AstroNolan/LU2EE20A_RefluxDansLesSoupapes/README.md

Projet universitaire d'électronique, permettant de déterminer le sens du flux d'air dans un tube (en se basant principalement sur le traitement analogique puis numérique de capteurs de température)
