AstroNolan/LU2EE20A_RefluxDansLesSoupapes/Mecanique - La Boite/Base.STEP

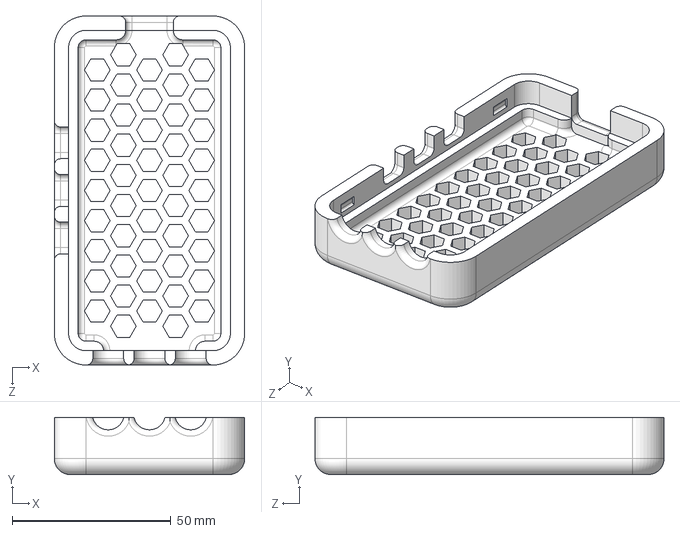
[picture p7: CAD file, 2025-03-15]
Mecanique - La Boite/Base.STEP
60.0 x 18.0 x 110.0 mm
