AstroNolan/LU2EE20A_RefluxDansLesSoupapes/Mecanique - La Boite/PCB.SLDPRT

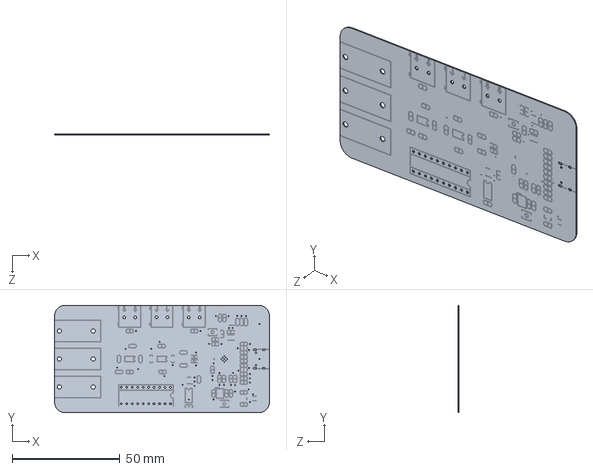
[picture p8: CAD file, 2025-03-15]
Mecanique - La Boite/PCB.SLDPRT
100.0 x 50.0 x 0.431 mm
