AstroNolan/LU2EE20A_RefluxDansLesSoupapes/Mecanique - La Boite/Chapo.STEP

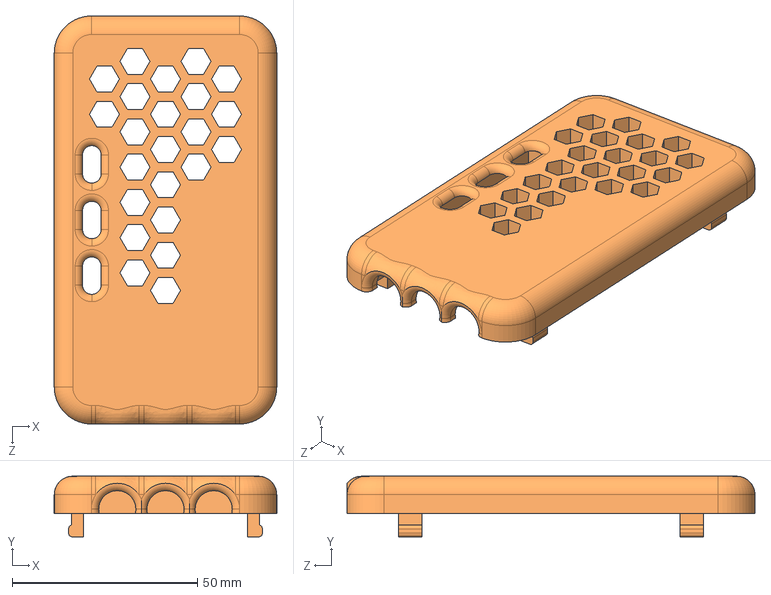
[picture p9: CAD file, 2025-03-15]
Mecanique - La Boite/Chapo.STEP
60.0 x 16.4 x 110.0 mm
