AstroNolan/LU2EE20A_RefluxDansLesSoupapes/Mecanique - La Boite/LaBoite.SLDASM

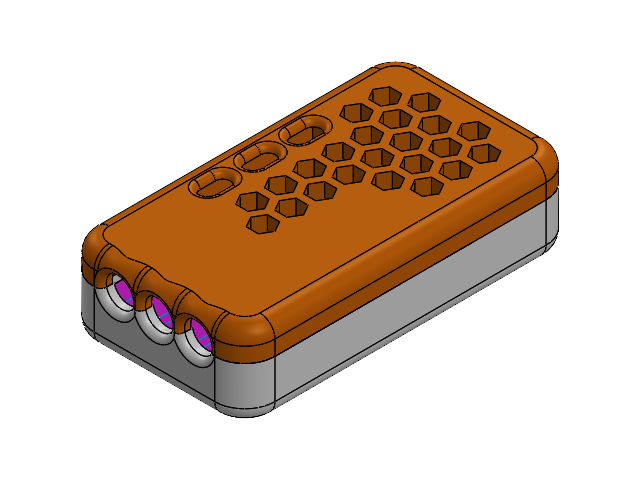
[picture p10: CAD file, 2025-03-15]
Mecanique - La Boite/LaBoite.SLDASM
Base
PCB
Chapo
