AstroNolan/LU2EE20A_RefluxDansLesSoupapes/(list of files, cad)

Other CAD files:
Mecanique - La Boite/Base.SLDPRT
Mecanique - La Boite/Chapo.SLDPRT
