AstroNolan/LU2EE20A_RefluxDansLesSoupapes/Electronique - Les Soupapes de l'Extrême/Les Soupapes de l'Extrême.pdf

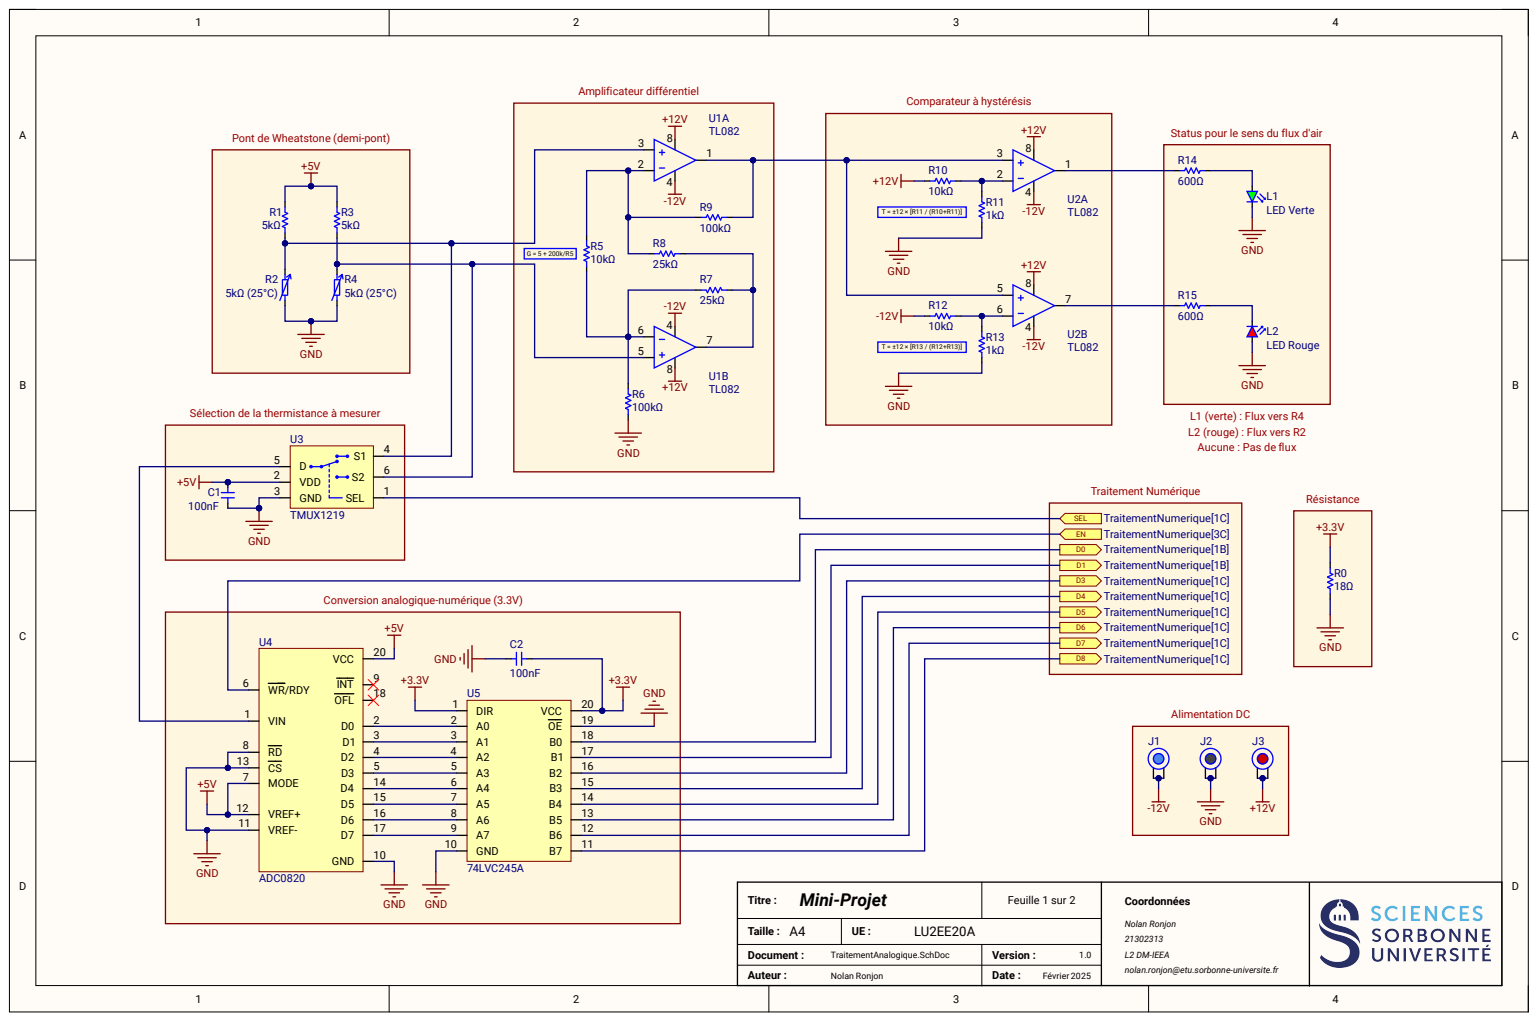
[picture p11: page 1]

Pont de Wheatstone (demi-pont)

Status pour le sens du f

élection de la thermistance

Conversion analogique-num érique (3.3V)

Mini-Projet | F euille 1 sur 2 | Coordonn ées Nolan Ronjon 21302313 L2 DM-IEEA nolan .ronjon@etu .sorbon ne-u niversite. fr

Document : T raitementAnalogique.SchDo c | Version : 1 . 0

Auteur : Nolan Ronjon | Date : F évrier 2 0 2 5

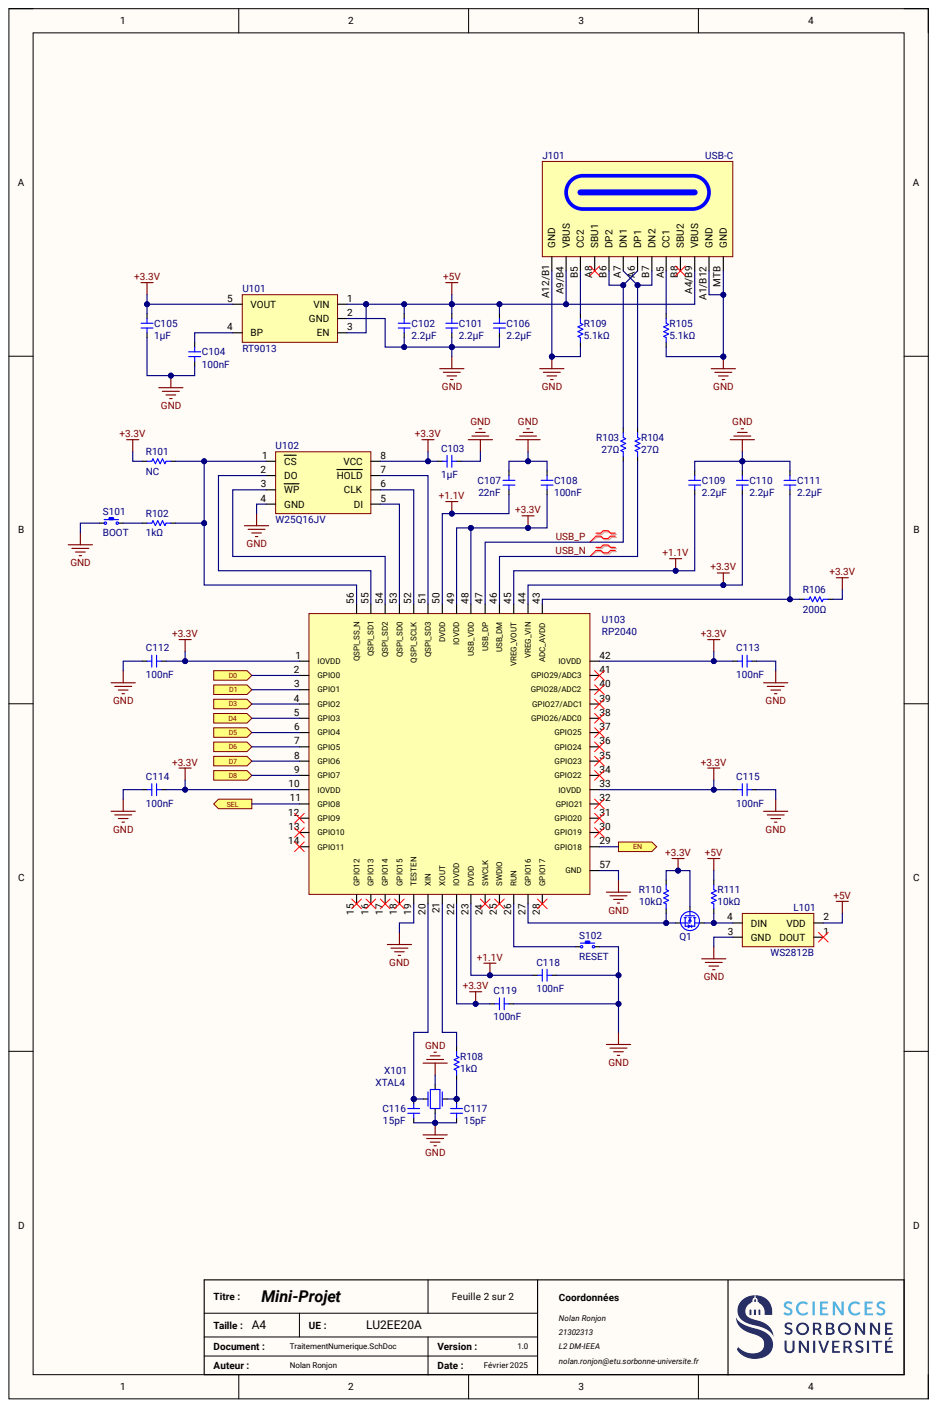
[picture p12: page 2]

GND MTB GND A1/B12 VBUS A4/B9

Mini-Projet Titre : | Feuille 2 sur 2 | Coordonnées Nolan Ronjon 21302313 L2 DM-IEEA nolan.ronjon@etu.sorbonne-universite.fr

A4 Taille : | UE : LU2EE20A

Document : TraitementNumerique.SchDoc | Version : 1.0

Auteur : Nolan Ronjon | Date : Février 2025

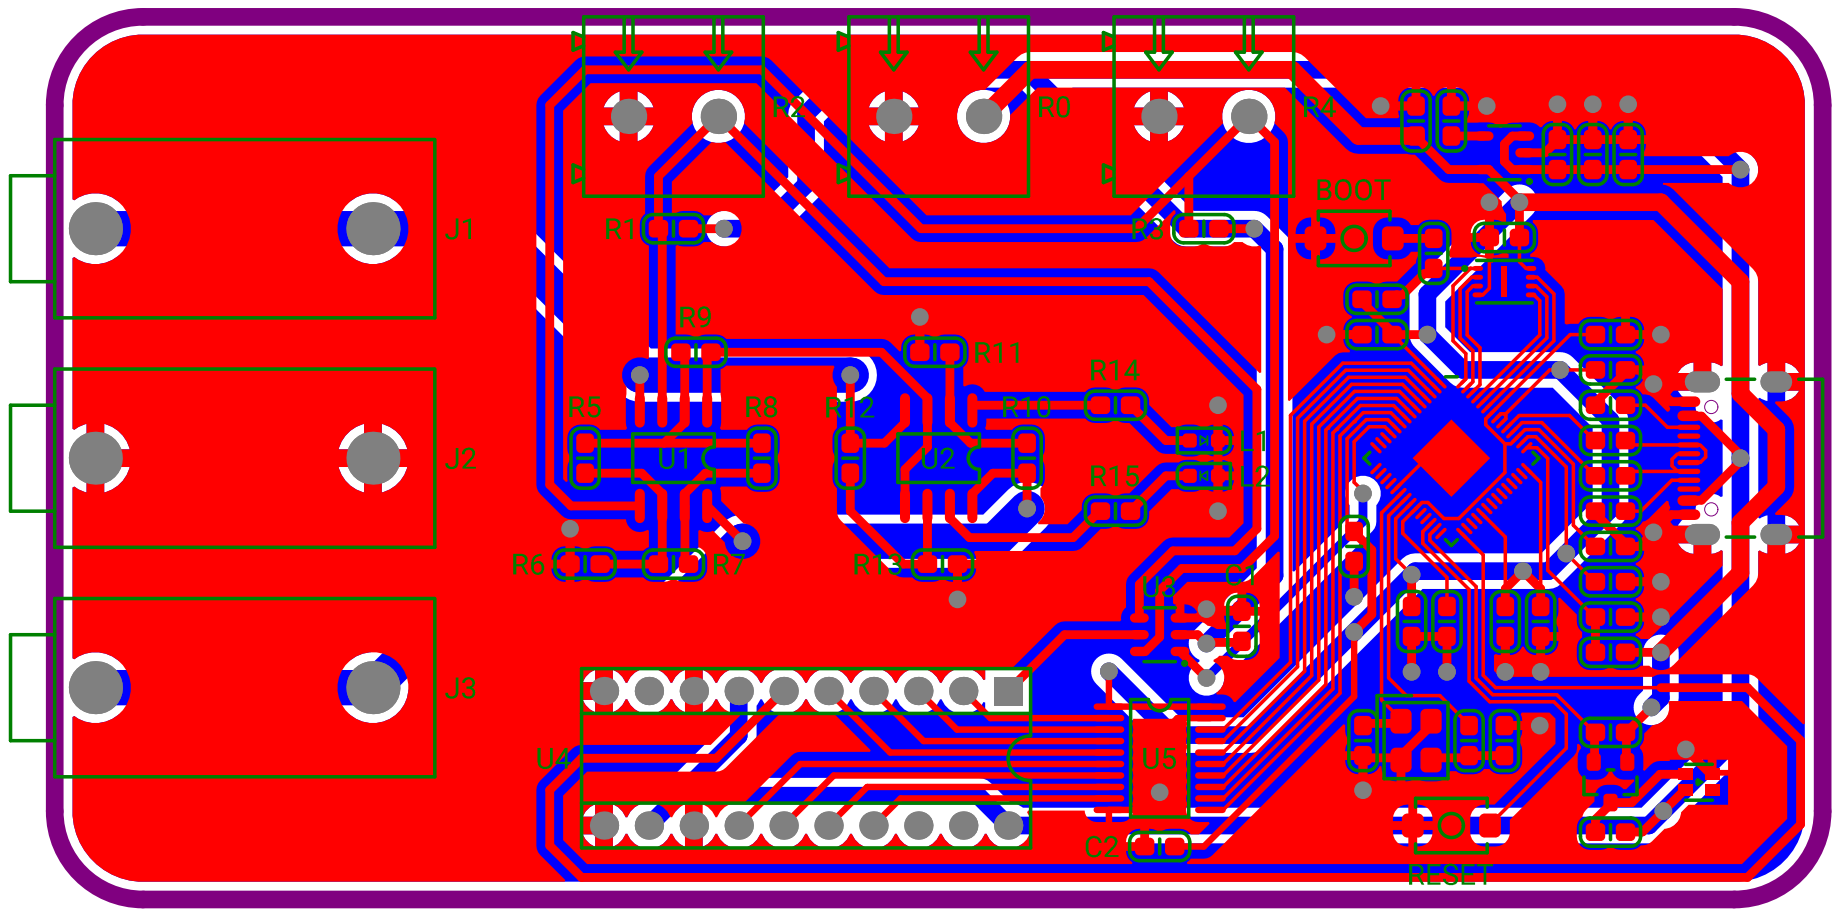
[picture p13: page 3]
