AstroNolan/LU2EE20A_RefluxDansLesSoupapes/(list of files, drawings)

Other design files:
Electronique - Les Soupapes de l'Extrême/Bobokeros.PcbDoc
Electronique - Les Soupapes de l'Extrême/Les Soupapes de l'Extrême.PrjPcb
Electronique - Les Soupapes de l'Extrême/LU2EE20A.PcbLib
Electronique - Les Soupapes de l'Extrême/LU2EE20A.SchLib
Electronique - Les Soupapes de l'Extrême/TraitementAnalogique.SchDoc
Electronique - Les Soupapes de l'Extrême/TraitementNumerique.SchDoc
